lxp32/lxp32-cpu/misc/highlight/readme.txt

This directory contains LXP32 assembly language syntax highlighting
rules for the following text editors:

  * AkelPad (http://akelpad.sourceforge.net/)
  * Notepad++ (https://notepad-plus-plus.org/)
