lxp32/lxp32-cpu/doc/src/trm/images/instructionformat.pdf

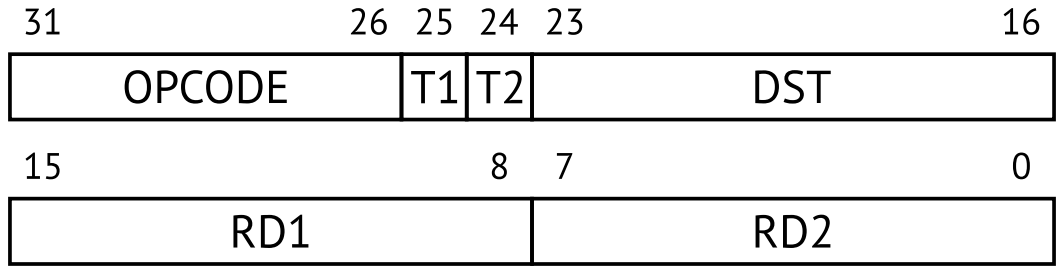
[picture p8: page 1]
