lxp32/lxp32-cpu/doc/src/trm/images/blockdiagram.pdf

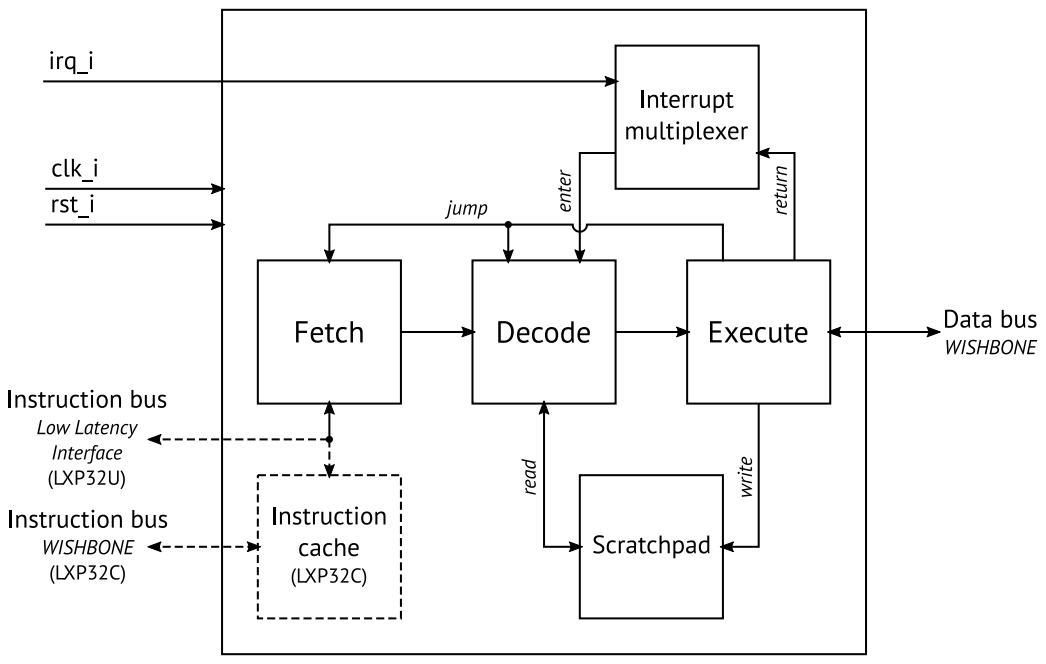
[picture p9: page 1]
