lxp32/lxp32-cpu/doc/src/trm/images/dbustiming.pdf

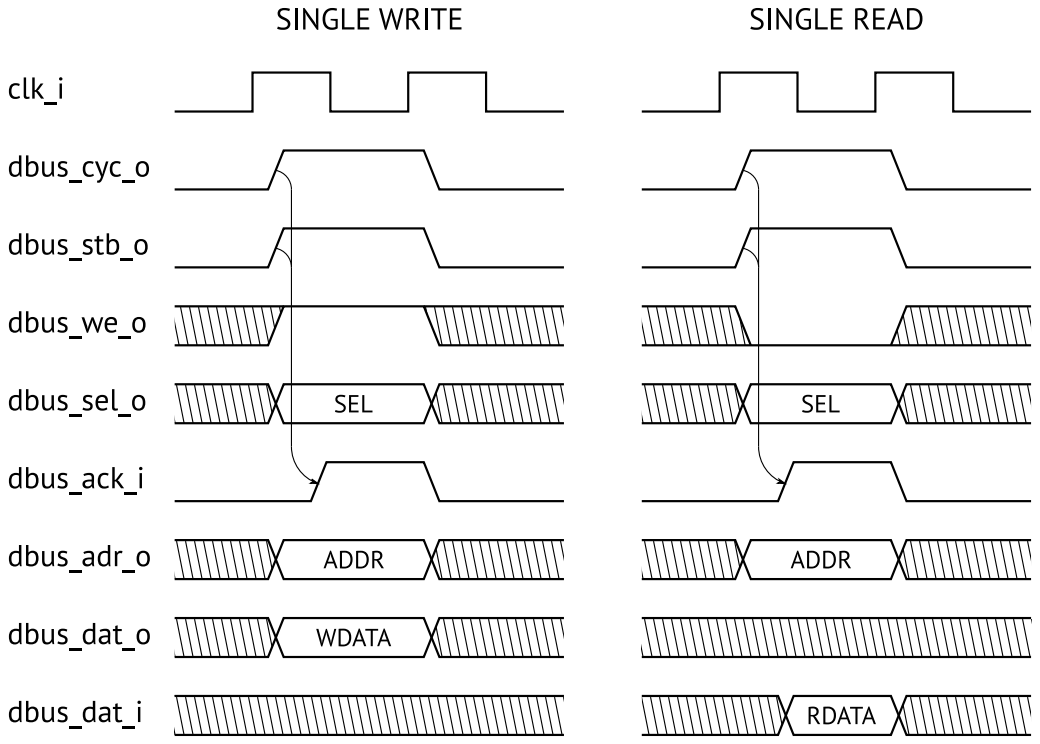
[picture p10: page 1]
