lxp32/lxp32-cpu/doc/src/trm/images/ibustiming.pdf

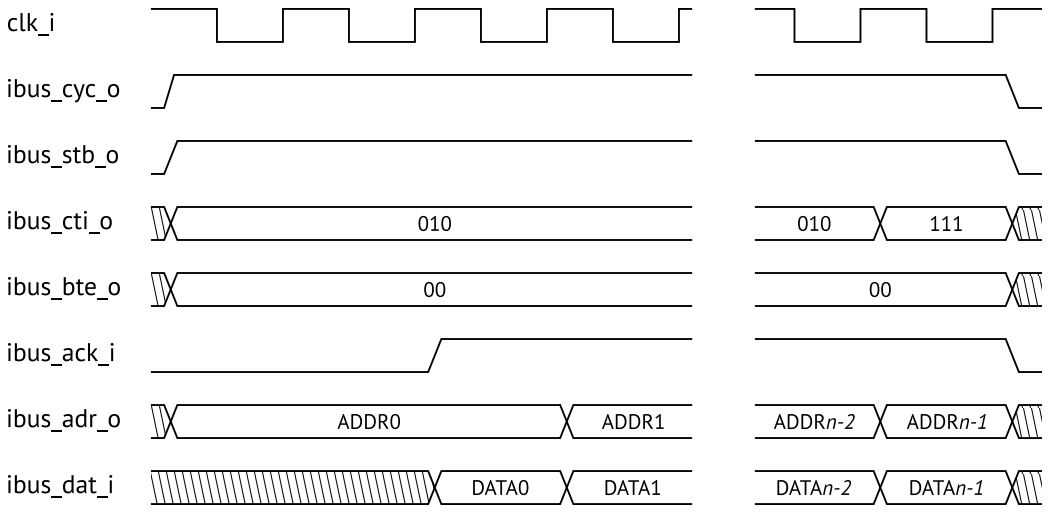
[picture p11: page 1]
