lxp32/lxp32-cpu/doc/src/trm/images/llitiming.pdf

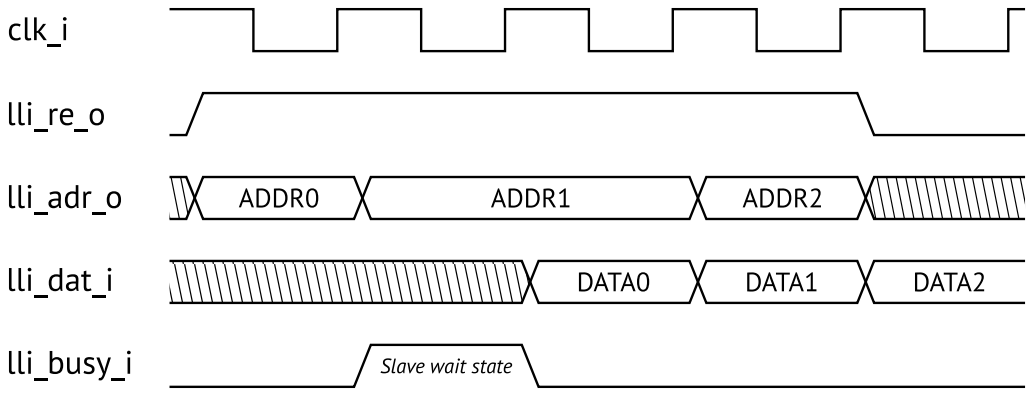
[picture p12: page 1]
