lxp32/lxp32-cpu/doc/src/trm/images/resetsync.pdf

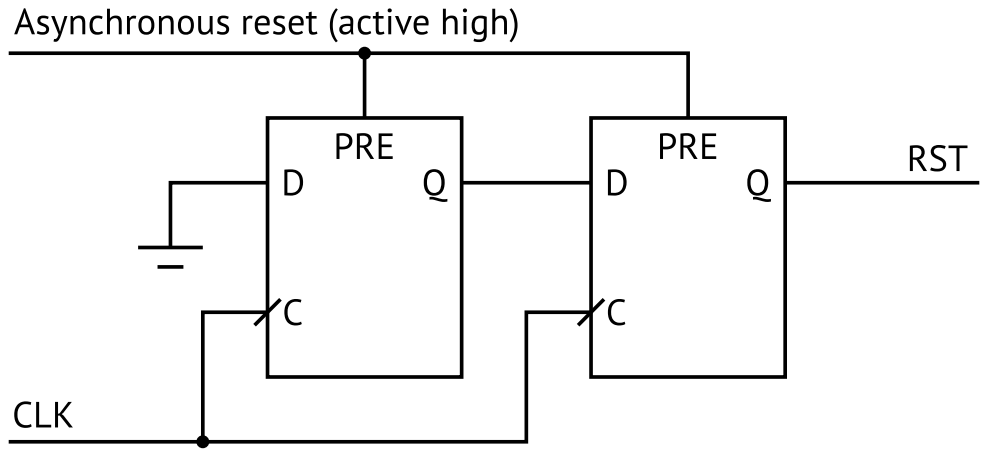
[picture p13: page 1]
