lxp32/lxp32-cpu/doc/src/trm/images/symbols.pdf

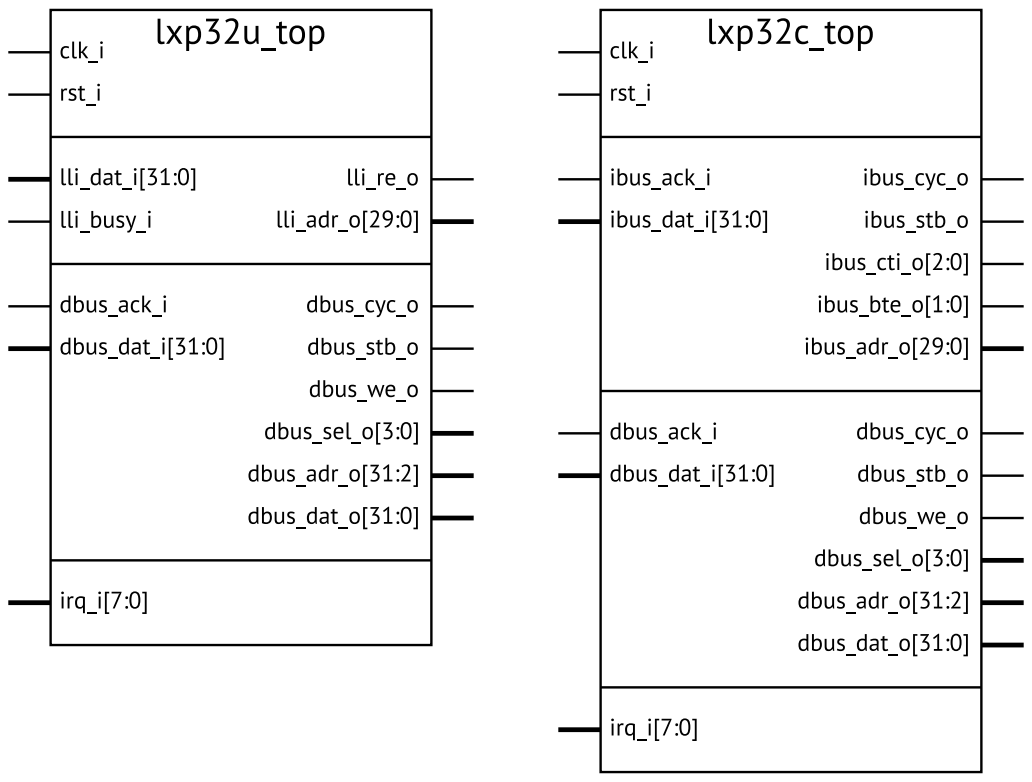
[picture p14: page 1]
