lxp32/lxp32-cpu/(commit log)

2016-02-21 testbench: replace linear congruent RNG using a shared state with an RNG based on "uniform" procedure from ieee.math_real which uses a process-local state variable. Because of this, pseudorandom sequ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
    [common_pkg.vhd, common_pkg_body.vhd, cpu_model.vhd, ram_model.vhd]
2016-02-24 rtl: workaround for inconsistent VHDL support in older versions of XST
    [generic_dpram.vhd]
2016-03-02 assembler: remove useless diagnostics
2016-03-10 rtl: move interrupt control registers to the lxp32_interrupt_mux design unit
2016-03-11 assembler: produce an error message when block comment is not closed
    [assembler.cpp]
2017-12-29 assembler, disassembler: support the new lc16 instruction
2018-01-04 tb: a new, more thorough, interrupt handling test has been added
2018-10-16 lc18 instruction replaced with lc21
    [assembler.cpp, assembler.h, disassembler.cpp, disassembler.h, linker.cpp, lxp32_decode.vhd]
2018-10-19 assembler: report number of words in the image
2018-10-21 assembler: better register name validation
2018-10-24 assembler: add option to generate map file
2018-10-25 assembler: better warning messages
2018-10-26 assembler: alignment must be a multiple of 4
2018-10-26 assembler: alignment must be a power of 2
2018-10-26 assembler: update help message
2018-10-27 assembler: eliminate unreferenced objects during the link stage
2018-10-27 assembler: remove symbols from unreferenced objects
2018-10-27 assembler: cleanup
2018-10-27 assembler: change syntax for handling public symbols
2018-10-27 assembler: sort symbols by address in linker map
2018-10-27 assembler: fix map generation
    [linker.cpp]
2018-10-28 assembler: preserve the order of non-entry objects
2018-10-28 assembler: improve map presentation
2018-10-28 verify: test for non-returnable interrupts
2018-10-28 assembler: improve input file type detection
2018-11-11 rtl: decoder: remove redundant logic in command modifier drivers
2018-11-13 rtl: fetch stage optimization (don't put fetch_addr into the buffer)
2018-11-14 assembler: rename "section alignment" to "object alignment", map format improved
2018-11-17 test020: better test for pipeline hazards, just in case
2018-11-21 assembler: don't expand a macro identifier in the #define statement
2018-11-22 assembler: take labels into account
2018-12-02 verify: fix ACK signal generation in the test platform
    [program_ram.vhd]
2018-12-09 assembler: entry symbol name can now be written as "entry" or "Entry"
2018-12-13 assembler: disallow labels at the end of a file
2021-10-12 assembler: allow labels at the end of included files
2021-10-17 assembler: exceptions fixed
2021-10-17 assembler: add #ifdef/#ifndef/#else/#endif directives
2021-10-17 assembler: add #error directive
    [assembler.cpp]
2021-10-17 assembler: fix conditionals implementation
    [assembler.cpp]
2022-08-28 redesign interrupts: replace cont_i signal with wake-up interrupts, remove support for temporarily blocked interrupts
    [lxp32_cpu.vhd, lxp32_decode.vhd, lxp32_interrupt_mux.vhd, platform.vhd, tb.vhd]
2024-11-02 add level sensitive interrupts
2024-11-02 interrupts can be level-sensitive and wake-up at the same time
2024-11-02 tb: add missing test
    [tb.vhd]
2024-11-02 tb: improve interrupt trigger mode test
2026-09-05 tb: direct comparison of strings of different length can be problematic in VHDL
    [tb.vhd]
